basbaccarne/StoryButtons/(commit log)

2025-05-26 Enhance README.md with detailed test descriptions and add new test scripts for capacitive touch, LED ring animations, and button functionality
2025-05-26 Implement button and hub modules with ESP-NOW communication for audio control
2025-05-26 Refactor button and hub modules for improved data handling and readability
2025-05-27 Update README.md to enhance parts list with detailed components and quantities; add action items for assembly and testing
2025-05-27 Update README.md to correct parts list by adding missing links and adjusting costs for diode and custom PCB
2025-05-28 Update README.md to add missing components and links in the parts list; include new LED softpulse test script and targetted audio test script
    [hub.ino, softpulse.ino, targetted_audio.ino]
2025-05-28 Update README.md to remove total cost placeholder; modify button.ino to enhance playback stop message and send stop signal; update targetted_audio.ino track metadata with new names and durations
2025-05-28 Update README.md to correct the description of the female barrel connection to specify PCB
2025-05-28 Update README.md to add construction details for button module, including laser cutting settings and 3D printing information
2025-05-29 Update README.md and button/hub modules to improve clarity and functionality; add button ESP-NOW test code
2025-05-29 Refactor button state handling to improve push detection logic and streamline state transitions
2025-05-29 Add debounce delay to idle and playing sequences for improved button responsiveness
2025-05-30 Refactor button and hub modules for improved state handling and data processing; enhance audio playback logic and add new state management
2025-05-30 Enhance button state handling by improving overlap stop logic and adding debug messages for better tracking of state transitions
2025-05-30 Refactor button module to improve LED handling and state transitions; adjust button and LED pin assignments, enhance LED effects for different states, and streamline state change logic.
2025-05-31 Refactor LED playback logic in button module to simplify code and enhance visual feedback; replace pulsating effect with solid blue color during playback.
    [button.ino]
2025-05-31 Update README to clarify button functionality: add detail on stopping audio with a second push and note that other buttons can interrupt playback.
2025-06-01 Fix typos and improve clarity in README background section and PCB workflow instructions
2025-06-01 Add boot LED blink sequence to indicate hub readiness
2025-06-09 Add LED test script for NeoPixel strip functionality
    - Implemented a test script to sequentially light up each LED in a NeoPixel strip.
    - The script initializes the LED strip and turns on each LED in red with a specified delay.
    - Added serial output to monitor the status of each LED during the test.
2025-06-11 Update README with additional lightbulb options and wiring instructions; add relay test script for setup verification
2025-06-11 Update README to include details about invention light bulbs and clarify button and hub functionalities; enhance construction instructions
2025-06-21 Update parts list in README with new links for E27 light bulb socket and C8 female wall connector
2025-06-24 Enhance button and hub modules with improved data handling and communication features
2025-07-05 Update README and hub module with corrected MAC addresses and audio track durations
    [bulb.ino, hub.ino]
